buk7456/Arduino-RC-basic-transmitter/channel_order.txt

Channel 1 => Ail
Channel 2 => Ele
Channel 3 => Thr
Channel 4 => Rud
Channel 5 => Knob
Channel 6 => SwitchA
