buk7456/Arduino-RC-basic-transmitter/schematics/receiver.pdf

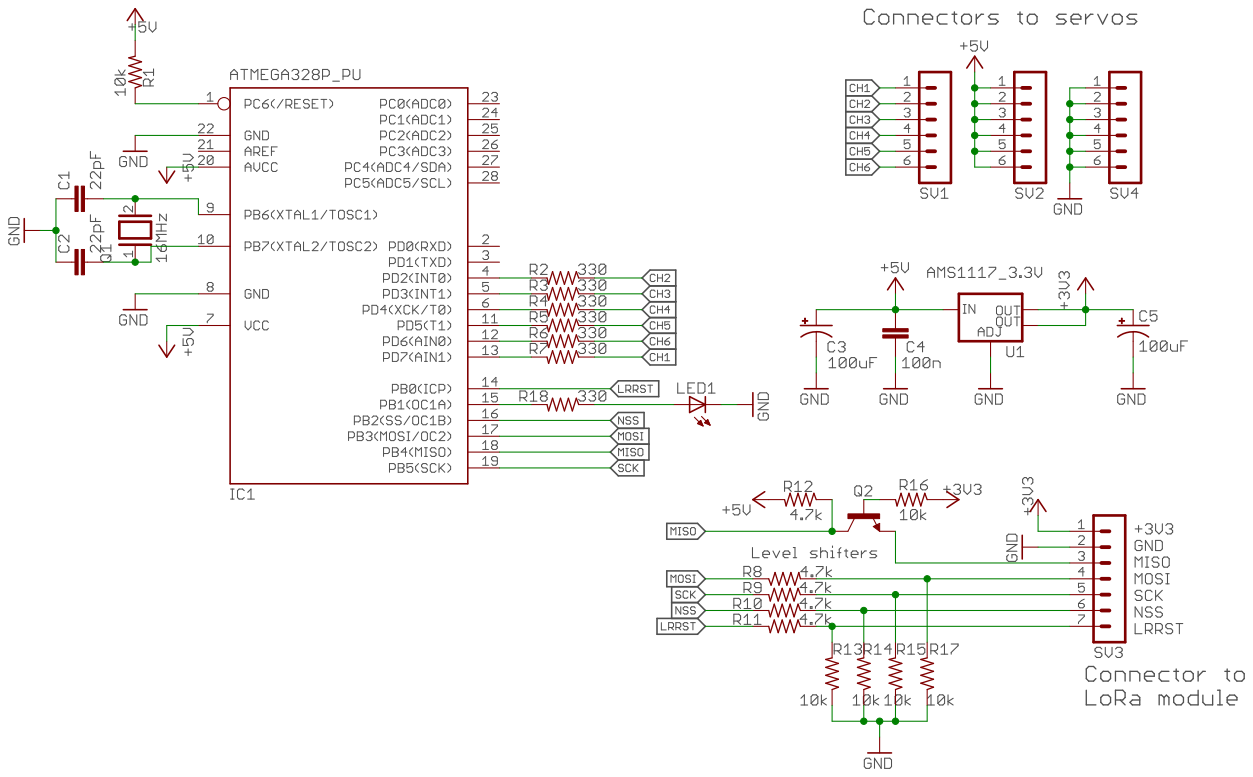
[picture p1: page 1]
