buk7456/Arduino-RC-basic-transmitter/schematics/transmitter.pdf

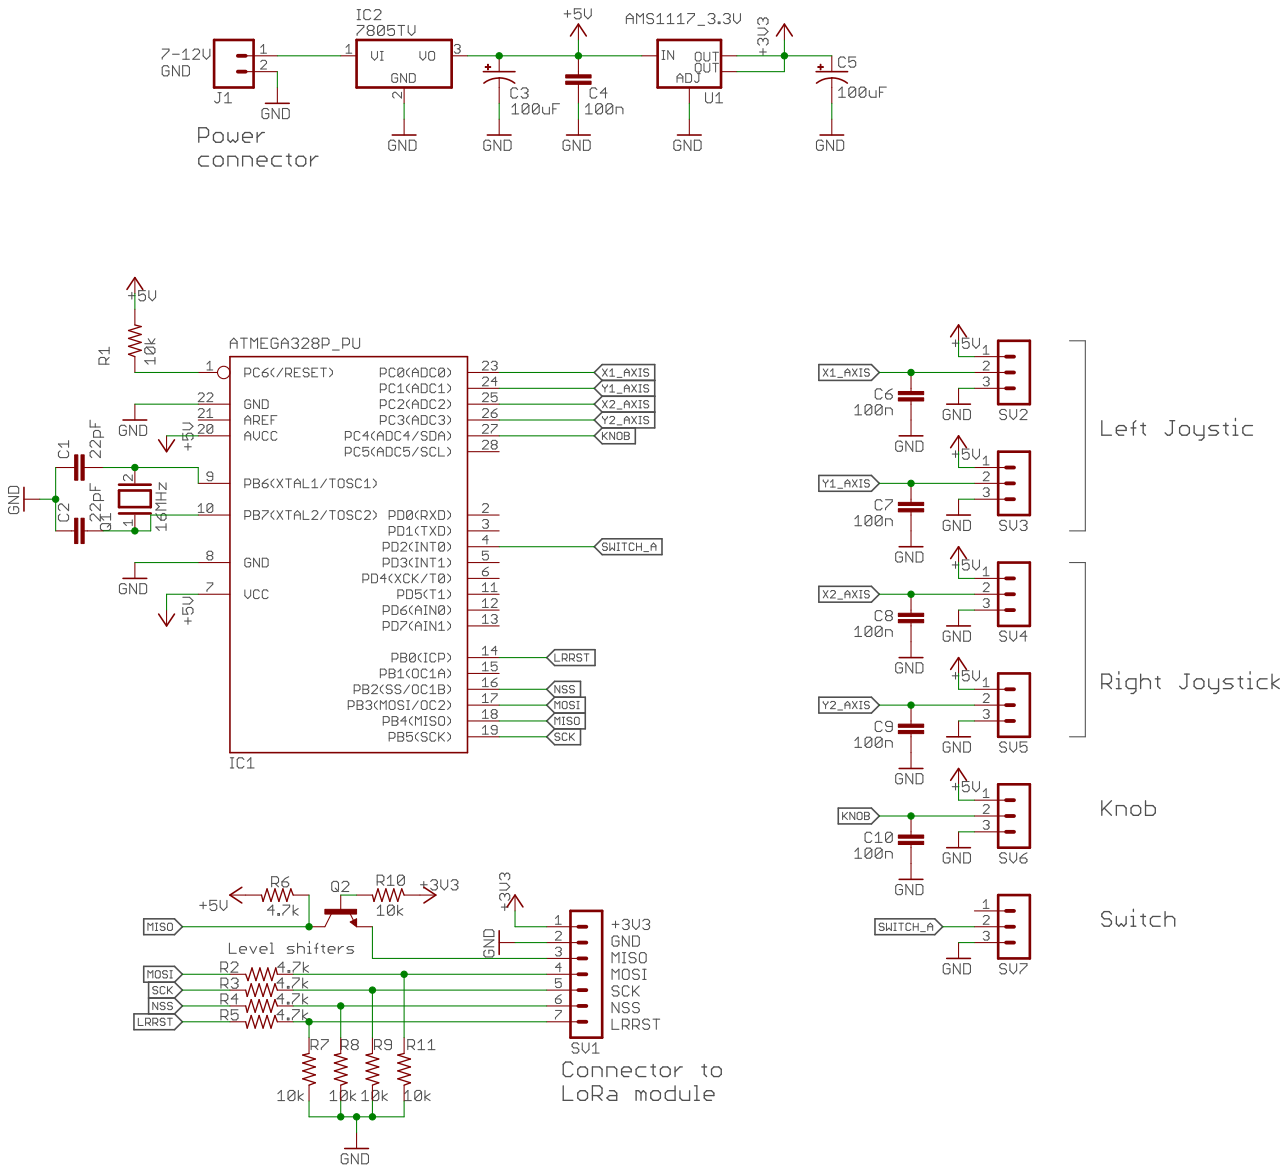
[picture p2: page 1]
