buk7456/Arduino-RC-basic-transmitter/schematics/receiver.sch

## EAGLE design schematics/receiver.sch (2023-11-17)

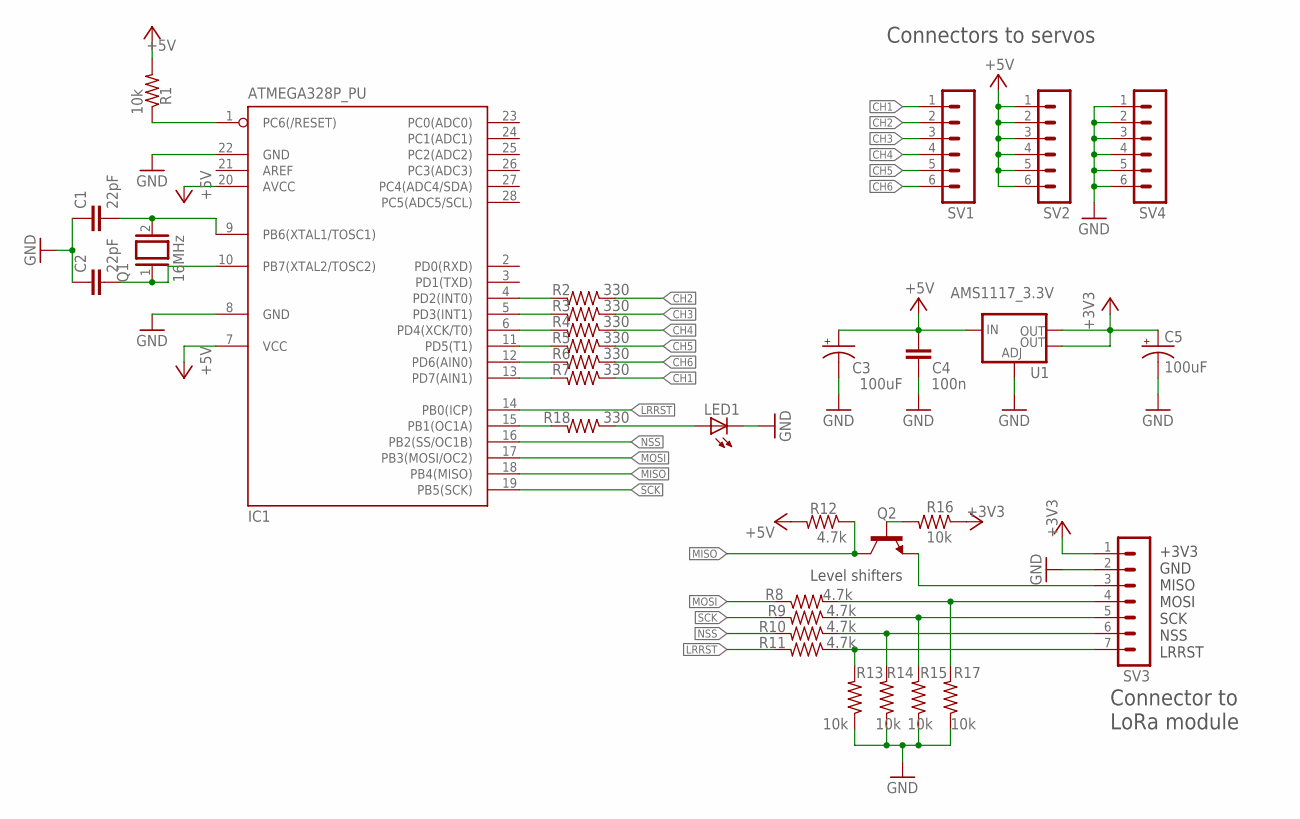
[picture p3: schematic receiver.sch]

Parts:
C1, C2: 22pF; C025-025X050
C3, C5: 100uF; E2,5-6E
C4: 100n; C025-025X050
IC1: ATMEGA328P_PU; DIL28-3
LED1: LED3MM
Q1: 16MHz; QS
Q2: BC817-16SMD; SOT23-BEC
R1, R13, R14, R15, R16, R17: 10k; R0805
R2, R3, R4, R5, R6, R7, R18: 330; R0805
R8, R9, R10, R11, R12: 4.7k; R0805
SV1, SV2, SV4: MA06-1
SV3: MA07-1
U1: AMS1117_3.3V; SOT223

Connections:
+3V3: C5.+, R16.1, SV3.1, U1.2 (OUT), U1.4 (OUT)
+5V: C3.+, C4.2, IC1.7 (VCC), IC1.20 (AVCC), R1.2, R12.2, SV2.1, SV2.2, SV2.3, SV2.4, SV2.5, SV2.6, U1.3 (IN)
CH1: R7.1, SV1.1
CH2: R2.1, SV1.2
CH3: R3.1, SV1.3
CH4: R4.1, SV1.4
CH5: R5.1, SV1.5
CH6: R6.1, SV1.6
GND: C1.1, C2.1, C3.-, C4.1, C5.-, IC1.8 (GND), IC1.22 (GND), LED1.K (C), R13.1, R14.1, R15.1, R17.1, SV3.2, SV4.1, SV4.2, SV4.3, SV4.4, SV4.5, SV4.6, U1.1 (ADJ)
LRRST: IC1.14 (PB0(ICP)), R11.2
MASTER_RST1: IC1.1 (PC6(/RESET)), R1.1
MISO: IC1.18 (PB4(MISO)), Q2.C, R12.1
MOSI: IC1.17 (PB3(MOSI/OC2)), R8.1
unnamed: Q2.B, R16.2
unnamed: Q2.E, SV3.3
unnamed: R9.1, R15.2, SV3.5
unnamed: R8.2, R17.2, SV3.4
unnamed: IC1.4 (PD2(INT0)), R2.2
unnamed: IC1.5 (PD3(INT1)), R3.2
unnamed: IC1.6 (PD4(XCK/T0)), R4.2
unnamed: IC1.11 (PD5(T1)), R5.2
unnamed: IC1.12 (PD6(AIN0)), R6.2
unnamed: R10.1, R14.2, SV3.6
unnamed: IC1.13 (PD7(AIN1)), R7.2
unnamed: R11.1, R13.2, SV3.7
unnamed: LED1.A, R18.1
unnamed: IC1.15 (PB1(OC1A)), R18.2
unnamed: C1.2, IC1.9 (PB6(XTAL1/TOSC1)), Q1.2
unnamed: C2.2, IC1.10 (PB7(XTAL2/TOSC2)), Q1.1
NSS: IC1.16 (PB2(SS/OC1B)), R10.2
SCK: IC1.19 (PB5(SCK)), R9.2

Notes on the sheet:
+3V3 GND MISO MOSI SCK NSS LRRST
Connector to LoRa module
Level shifters
Connectors to servos
