buk7456/Arduino-RC-basic-transmitter/schematics/transmitter.sch

## EAGLE design schematics/transmitter.sch (2023-11-17)

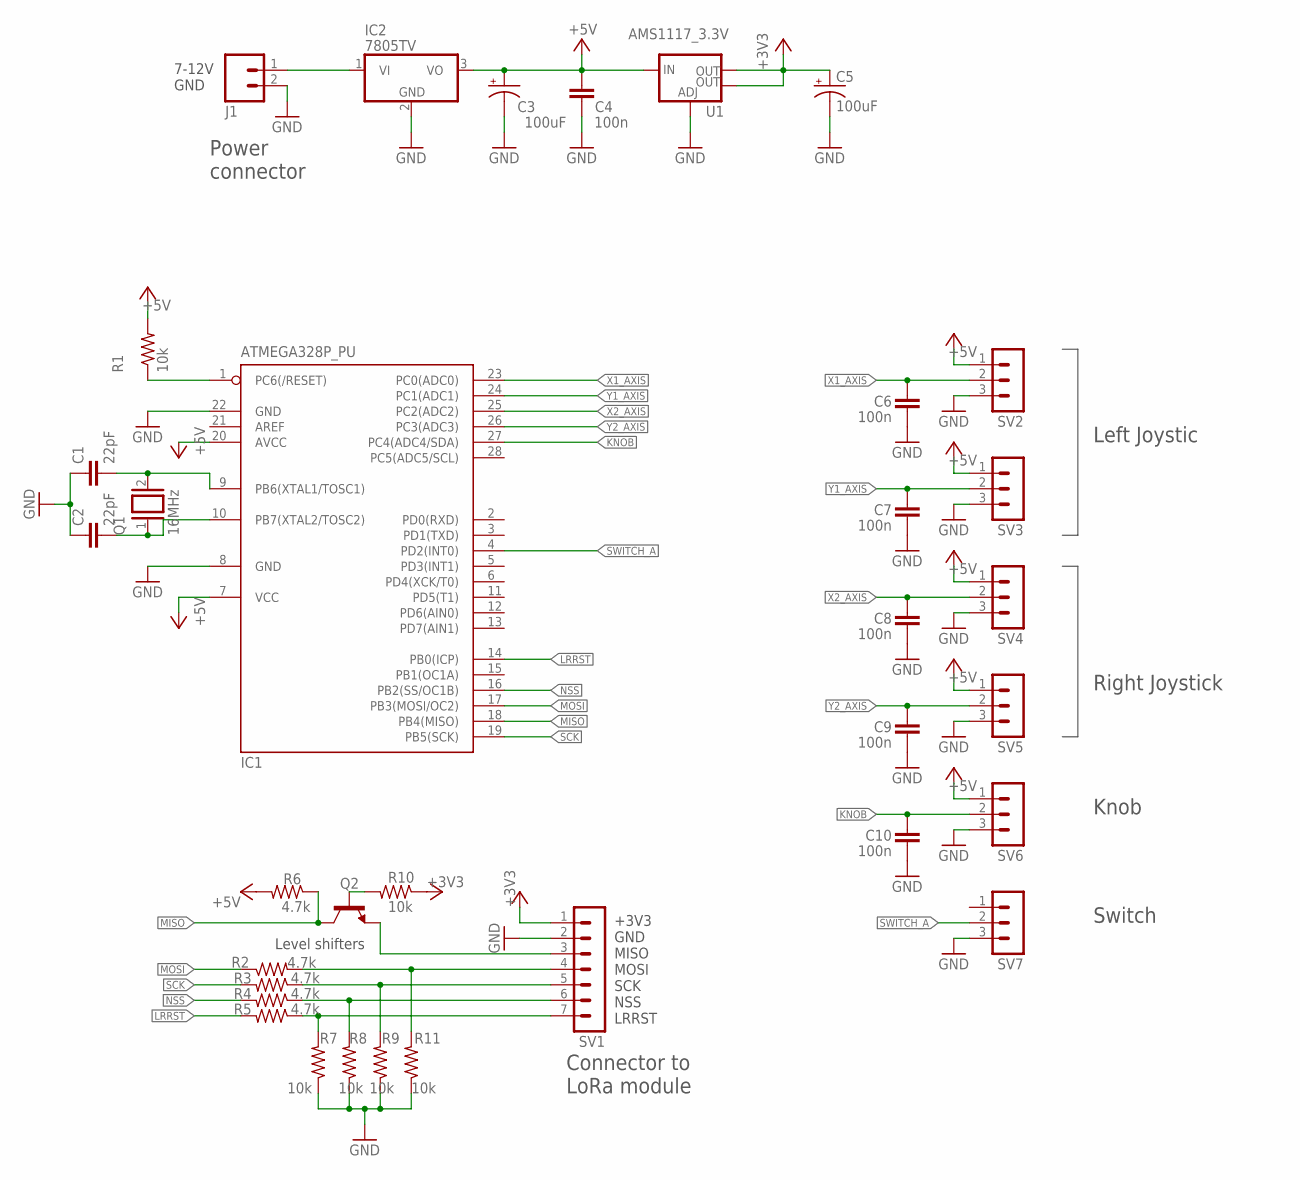
[picture p4: schematic transmitter.sch]

Parts:
C1, C2: 22pF; C025-025X050
C3, C5: 100uF; E2,5-6E
C4, C6, C7, C8, C9, C10: 100n; C025-025X050
IC1: ATMEGA328P_PU; DIL28-3
IC2: 7805TV; TO220V
J1: M02PTH; 1X02
Q1: 16MHz; QS
Q2: BC817-16SMD; SOT23-BEC
R1: 10k; 0204/5
R2, R3, R4, R5, R6: 4.7k; R0805
R7, R8, R9, R10, R11: 10k; R0805
SV1: MA07-1
SV2, SV3, SV4, SV5, SV6, SV7: MA03-1
U1: AMS1117_3.3V; SOT223

Connections:
7-12V_IN: IC2.1 (VI), J1.1
+3V3: C5.+, R10.1, SV1.1, U1.2 (OUT), U1.4 (OUT)
+5V: C3.+, C4.2, IC1.7 (VCC), IC1.20 (AVCC), IC2.3 (VO), R1.2, R6.2, SV2.1, SV3.1, SV4.1, SV5.1, SV6.1, U1.3 (IN)
GND: C1.1, C2.1, C3.-, C4.1, C5.-, C6.1, C7.1, C8.1, C9.1, C10.1, IC1.8 (GND), IC1.22 (GND), IC2.2 (GND), J1.2, R7.1, R8.1, R9.1, R11.1, SV1.2, SV2.3, SV3.3, SV4.3, SV5.3, SV6.3, SV7.3, U1.1 (ADJ)
KNOB: C10.2, SV6.2
LRRST: IC1.14 (PB0(ICP)), R5.2
MASTER_RST1: IC1.1 (PC6(/RESET)), R1.1
MISO: IC1.18 (PB4(MISO)), Q2.C, R6.1
MOSI: IC1.17 (PB3(MOSI/OC2)), R2.1
unnamed: Q2.B, R10.2
unnamed: Q2.E, SV1.3
unnamed: R3.1, R9.2, SV1.5
unnamed: R2.2, R11.2, SV1.4
unnamed: R4.1, R8.2, SV1.6
unnamed: R5.1, R7.2, SV1.7
unnamed: C1.2, IC1.9 (PB6(XTAL1/TOSC1)), Q1.2
unnamed: C2.2, IC1.10 (PB7(XTAL2/TOSC2)), Q1.1
NSS: IC1.16 (PB2(SS/OC1B)), R4.2
SCK: IC1.19 (PB5(SCK)), R3.2
SWITCH_A: IC1.4 (PD2(INT0)), SV7.2
X1_AXIS: C6.2, SV2.2
X2_AXIS: C8.2, SV4.2
Y1_AXIS: C7.2, SV3.2
Y2_AXIS: C9.2, SV5.2

Notes on the sheet:
+3V3 GND MISO MOSI SCK NSS LRRST
Connector to LoRa module
Level shifters
7-12V GND
Power connector
Left Joystic
Right Joystick
Knob
Switch
